Kirs67/undergrad-thesis/top_controller/top_controller.kicad_pcb

## KiCad design top_controller/top_controller.kicad_pcb (2023-03-27)

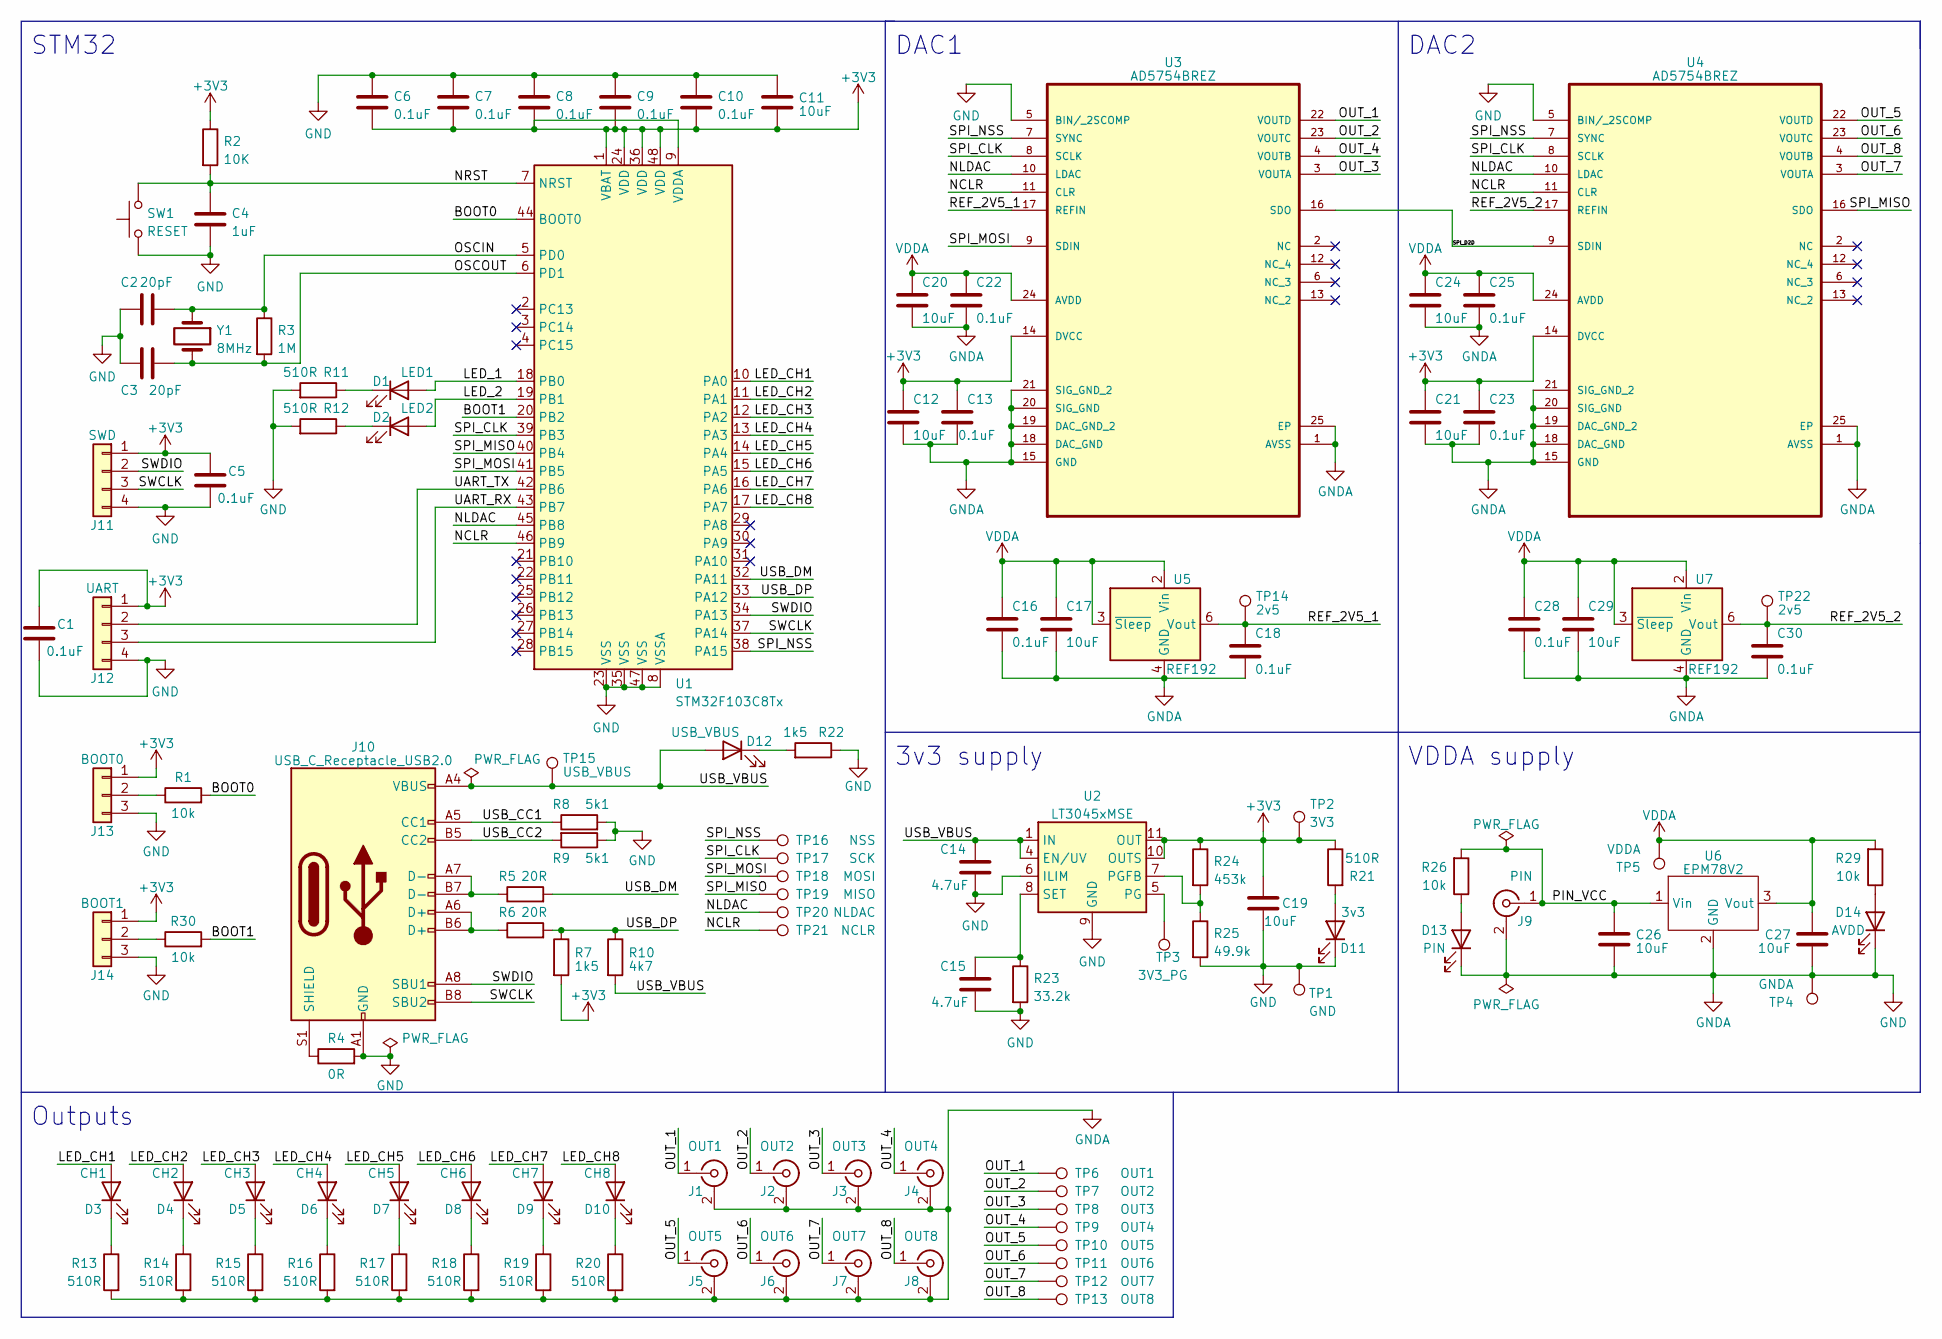
[picture p1: schematic top_controller.kicad_sch, Photonic control curcuit]

Parts:
C1, C5, C6, C7, C8, C9, C10, C13, C16, C18, C22, C23, C25, C28, C30: 0.1uF; C_0603_1608Metric
C2, C3: 20pF; C_0603_1608Metric
C4: 1uF; C_0603_1608Metric
C11, C12, C17, C19, C20, C21, C24, C26, C27, C29: 10uF; C_1206_3216Metric
C14, C15: 4.7uF; C_1206_3216Metric
D1: LED1; LED_0805_2012Metric
D2: LED2; LED_0805_2012Metric
D3: CH1; LED_0805_2012Metric
D4: CH2; LED_0805_2012Metric
D5: CH3; LED_0805_2012Metric
D6: CH4; LED_0805_2012Metric
D7: CH5; LED_0805_2012Metric
D8: CH6; LED_0805_2012Metric
D9: CH7; LED_0805_2012Metric
D10: CH8; LED_0805_2012Metric
D11: 3v3; LED_0805_2012Metric
D12: USB_VBUS; LED_0805_2012Metric
D13: PIN; LED_0805_2012Metric
D14: AVDD; LED_0805_2012Metric
J1: OUT1; CONBNC002
J2: OUT2; CONBNC002
J3: OUT3; CONBNC002
J4: OUT4; CONBNC002
J5: OUT5; CONBNC002
J6: OUT6; CONBNC002
J7: OUT7; CONBNC002
J8: OUT8; CONBNC002
J9: PIN; CONBNC002
J10: USB_C_Receptacle_USB2.0; USB_C_Receptacle_GCT_USB4105-xx-A_16P_TopMnt_Horizontal
J11: SWD; PinHeader_1x04_P2.54mm_Vertical
J12: UART; PinHeader_1x04_P2.54mm_Vertical
J13: BOOT0; PinHeader_1x03_P2.54mm_Vertical
J14: BOOT1; PinHeader_1x03_P2.54mm_Vertical
R1, R26, R29, R30: 10k; R_0603_1608Metric
R2: 10K; R_0603_1608Metric
R3: 1M; R_2512_6332Metric
R4: 0R; R_0603_1608Metric
R5, R6: 20R; R_0603_1608Metric
R7, R22: 1k5; R_0603_1608Metric
R8, R9: 5k1; R_0603_1608Metric
R10: 4k7; R_0603_1608Metric
R11, R12, R13, R14, R15, R16, R17, R18, R19, R20, R21: 510R; R_0603_1608Metric
R23: 33.2k; R_0603_1608Metric
R24: 453k; R_0805_2012Metric
R25: 49.9k; R_0603_1608Metric
SW1: RESET; SW_TS04-66-95-BK-100-SMT
TP1: GND; TestPoint_Keystone_5010-5014_Multipurpose
TP2: 3V3; TestPoint_Keystone_5010-5014_Multipurpose
TP3: 3V3_PG; TestPoint_Keystone_5010-5014_Multipurpose
TP4: GNDA; TestPoint_Keystone_5010-5014_Multipurpose
TP5: VDDA; TestPoint_Keystone_5010-5014_Multipurpose
TP6: OUT1; TestPoint_Keystone_5010-5014_Multipurpose
TP7: OUT2; TestPoint_Keystone_5010-5014_Multipurpose
TP8: OUT3; TestPoint_Keystone_5010-5014_Multipurpose
TP9: OUT4; TestPoint_Keystone_5010-5014_Multipurpose
TP10: OUT5; TestPoint_Keystone_5010-5014_Multipurpose
TP11: OUT6; TestPoint_Keystone_5010-5014_Multipurpose
TP12: OUT7; TestPoint_Keystone_5010-5014_Multipurpose
TP13: OUT8; TestPoint_Keystone_5010-5014_Multipurpose
TP14, TP22: 2v5; TestPoint_Keystone_5010-5014_Multipurpose
TP15: USB_VBUS; TestPoint_Keystone_5010-5014_Multipurpose
TP16: NSS; TestPoint_Keystone_5010-5014_Multipurpose
TP17: SCK; TestPoint_Keystone_5010-5014_Multipurpose
TP18: MOSI; TestPoint_Keystone_5010-5014_Multipurpose
TP19: MISO; TestPoint_Keystone_5010-5014_Multipurpose
TP20: NLDAC; TestPoint_Keystone_5010-5014_Multipurpose
TP21: NCLR; TestPoint_Keystone_5010-5014_Multipurpose
U1: STM32F103C8Tx; LQFP-48_7x7mm_P0.5mm
U2: LT3045xMSE; MSOP-12-1EP_3x4mm_P0.65mm_EP1.65x2.85mm
U3, U4: AD5754BREZ; SOP65P640X120-25N; MPN AD5754BREZ
U5, U7: REF192; SOIC-8_3.9x4.9mm_P1.27mm
U6: EPM78V2
Y1: 8MHz; Crystal_SMD_HC49-SD

Connections:
+3V3: C1.1, C5.1, C6.2, C7.2, C8.2, C9.2, C10.2, C11.2, C12.1, C13.1, C19.1, C21.1, C23.1, J11.1, J12.1, J13.1, J14.1, R2.1, R7.2, R21.1, R24.1, TP2.1, U1.1 (VBAT), U1.9 (VDDA), U1.24 (VDD), U1.36 (VDD), U1.48 (VDD), U2.10 (OUTS), U2.11 (OUT), U2.12 (OUT), U3.14 (DVCC), U4.14 (DVCC)
/BOOT0: R1.2, U1.44 (BOOT0)
/BOOT1: R30.2, U1.20 (PB2)
/LED_1: D1.2 (A), U1.18 (PB0)
/LED_2: D2.2 (A), U1.19 (PB1)
/LED_CH1: D3.2 (A), U1.10 (PA0)
/LED_CH2: D4.2 (A), U1.11 (PA1)
/LED_CH3: D5.2 (A), U1.12 (PA2)
/LED_CH4: D6.2 (A), U1.13 (PA3)
/LED_CH5: D7.2 (A), U1.14 (PA4)
/LED_CH6: D8.2 (A), U1.15 (PA5)
/LED_CH7: D9.2 (A), U1.16 (PA6)
/LED_CH8: D10.2 (A), U1.17 (PA7)
/NCLR: TP21.1, U1.46 (PB9), U3.11 (CLR), U4.11 (CLR)
/NLDAC: TP20.1, U1.45 (PB8), U3.10 (LDAC), U4.10 (LDAC)
/NRST: C4.1, R2.2, SW1.2, U1.7 (NRST)
/OSCIN: C2.1, R3.1, U1.5 (PD0), Y1.1
/OSCOUT: C3.1, R3.2, U1.6 (PD1), Y1.2
/OUT_1: J1.1 (In), TP6.1, U3.22 (VOUTD)
/OUT_2: J2.1 (In), TP7.1, U3.23 (VOUTC)
/OUT_3: J3.1 (In), TP8.1, U3.3 (VOUTA)
/OUT_4: J4.1 (In), TP9.1, U3.4 (VOUTB)
/OUT_5: J5.1 (In), TP10.1, U4.22 (VOUTD)
/OUT_6: J6.1 (In), TP11.1, U4.23 (VOUTC)
/OUT_7: J7.1 (In), TP12.1, U4.3 (VOUTA)
/OUT_8: J8.1 (In), TP13.1, U4.4 (VOUTB)
/PIN_VCC: C26.1, J9.1 (In), R26.2, U6.1 (Vin)
/REF_2V5_1: C18.1, TP14.1, U3.17 (REFIN), U5.6 (Vout)
/REF_2V5_2: C30.1, TP22.1, U4.17 (REFIN), U7.6 (Vout)
/SPI_CLK: TP17.1, U1.39 (PB3), U3.8 (SCLK), U4.8 (SCLK)
/SPI_D2D: U3.16 (SDO), U4.9 (SDIN)
/SPI_MISO: TP19.1, U1.40 (PB4), U4.16 (SDO)
/SPI_MOSI: TP18.1, U1.41 (PB5), U3.9 (SDIN)
/SPI_NSS: TP16.1, U1.38 (PA15), U3.7 (SYNC), U4.7 (SYNC)
/SWCLK: J10.B8 (SBU2), J11.3, U1.37 (PA14)
/SWDIO: J10.A8 (SBU1), J11.2, U1.34 (PA13)
/UART_RX: J12.3, U1.43 (PB7)
/UART_TX: J12.2, U1.42 (PB6)
/USB_CC1: J10.A5 (CC1), R8.1
/USB_CC2: J10.B5 (CC2), R9.2
/USB_DM: R5.2, U1.32 (PA11)
/USB_DP: R6.2, R7.1, R10.1, U1.33 (PA12)
/USB_VBUS: C14.1, D12.2 (A), J10.A4 (VBUS), J10.A9 (VBUS), J10.B4 (VBUS), J10.B9 (VBUS), R10.2, TP15.1, U2.1 (IN), U2.2 (IN), U2.3 (IN), U2.4 (EN/UV)
GND: C1.2, C2.2, C3.2, C4.2, C5.2, C6.1, C7.1, C8.1, C9.1, C10.1, C11.1, C12.2, C13.2, C14.2, C15.2, C16.2, C17.2, C18.2, C19.2, C20.2, C21.2, C22.2, C23.2, C24.2, C25.2, C26.2, C27.2, C28.2, C29.2, C30.2, D11.1 (K), D13.1 (K), D14.1 (K), J1.2 (Ext), J2.2 (Ext), J3.2 (Ext), J4.2 (Ext), J5.2 (Ext), J6.2 (Ext), J7.2 (Ext), J8.2 (Ext), J9.2 (Ext), J10.A1 (GND), J10.A12 (GND), J10.B1 (GND), J10.B12 (GND), J11.4, J12.4, J13.3, J14.3, R4.2, R8.2, R9.1, R11.2, R12.2, R13.2, R14.2, R15.2, R16.2, R17.2, R18.2, R19.2, R20.2, R22.1, R23.2, R25.2, SW1.1, TP1.1, TP4.1, U1.8 (VSSA), U1.23 (VSS), U1.35 (VSS), U1.47 (VSS), U2.6 (ILIM), U2.9 (GND), U2.13 (GND), U3.1 (AVSS), U3.5 (BIN/_2SCOMP), U3.15 (GND), U3.18 (DAC_GND), U3.19 (DAC_GND_2), U3.20 (SIG_GND), U3.21 (SIG_GND_2), U3.25 (EP), U4.1 (AVSS), U4.5 (BIN/_2SCOMP), U4.15 (GND), U4.18 (DAC_GND), U4.19 (DAC_GND_2), U4.20 (SIG_GND), U4.21 (SIG_GND_2), U4.25 (EP), U5.4 (GND), U6.2 (GND), U7.4 (GND)
unnamed: D1.1 (K), R11.1
unnamed: D2.1 (K), R12.1
unnamed: D3.1 (K), R13.1
unnamed: D4.1 (K), R14.1
unnamed: D5.1 (K), R15.1
unnamed: D6.1 (K), R16.1
unnamed: D7.1 (K), R17.1
unnamed: D8.1 (K), R18.1
unnamed: D9.1 (K), R19.1
unnamed: D10.1 (K), R20.1
unnamed: D11.2 (A), R21.2
unnamed: D12.1 (K), R22.2
unnamed: D13.2 (A), R26.1
unnamed: D14.2 (A), R29.1
unnamed: J10.A6 (D+), J10.B6 (D+), R6.1
unnamed: J10.A7 (D-), J10.B7 (D-), R5.1
unnamed: J10.S1 (SHIELD), R4.1
unnamed: J13.2, R1.1
unnamed: J14.2, R30.1
unnamed: TP3.1, U2.5 (PG)
unnamed: R24.2, R25.1, U2.7 (PGFB)
unnamed: C15.1, R23.1, U2.8 (SET)
VDDA: C16.1, C17.1, C20.1, C22.1, C24.1, C25.1, C27.1, C28.1, C29.1, R29.2, TP5.1, U3.24 (AVDD), U4.24 (AVDD), U5.2 (Vin), U5.3 (~Sleep), U6.3 (Vout), U7.2 (Vin), U7.3 (~Sleep)

Notes on the sheet:
DAC2
3v3 supply
Outputs
DAC1
VDDA supply
STM32

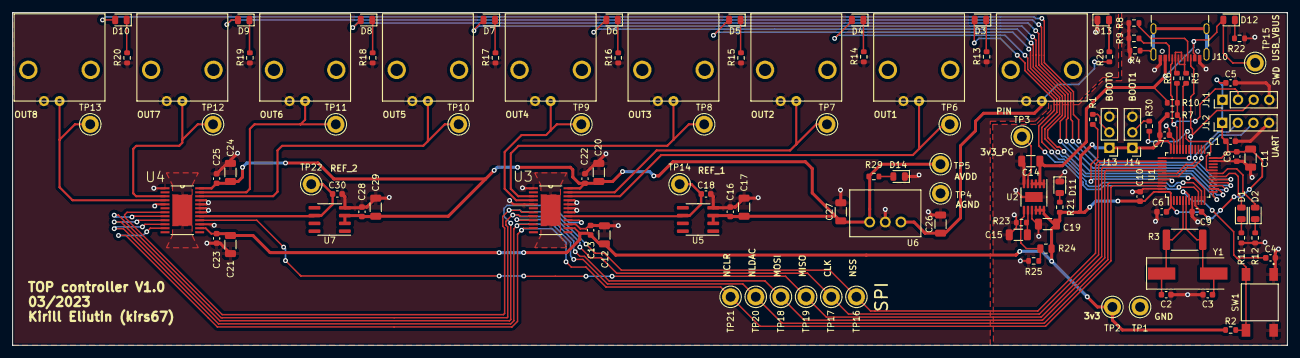
[picture p2: board top_controller.kicad_pcb from above]

Board: 2 copper layers, 207.7 x 54.2 mm, 117 parts (0 on the bottom side), 67 nets.
