Kirs67/undergrad-thesis/stm32_proj/stm32_proj.ioc

Mcu.UserName=STM32F103C8Tx
PA0-WKUP.GPIO_Label=LED_CH1
PA0-WKUP.Signal=GPIO_Output
PA1.GPIO_Label=LED_CH2
PA1.Signal=GPIO_Output
PA11.Signal=USB_DM
PA12.Signal=USB_DP
PA13.Signal=SYS_JTMS-SWDIO
PA14.Signal=SYS_JTCK-SWCLK
PA15.Signal=SPI1_NSS
PA2.GPIO_Label=LED_CH3
PA2.Signal=GPIO_Output
PA3.GPIO_Label=LED_CH4
PA3.Signal=GPIO_Output
PA4.GPIO_Label=LED_CH5
PA4.Signal=GPIO_Output
PA5.GPIO_Label=LED_CH6
PA5.Signal=GPIO_Output
PA6.GPIO_Label=LED_CH7
PA6.Signal=GPIO_Output
PA7.GPIO_Label=LED_CH8
PA7.Signal=GPIO_Output
PB0.GPIO_Label=LED1
PB0.Signal=GPIO_Output
PB1.GPIO_Label=LED2
PB1.Signal=GPIO_Output
PB2.GPIO_Label=BOOT1
PB2.Signal=GPIO_Input
PB3.Signal=SPI1_SCK
PB4.Signal=SPI1_MISO
PB5.Signal=SPI1_MOSI
PB6.Signal=USART1_TX
PB7.Signal=USART1_RX
PB8.GPIO_Label=NLDAC
PB8.Signal=GPIO_Output
PB9.GPIO_Label=NCLR
PB9.Signal=GPIO_Output
PD0-OSC_IN.Signal=RCC_OSC_IN
PD1-OSC_OUT.Signal=RCC_OSC_OUT
