Kirs67/undergrad-thesis/(commit log)

2023-03-12 Most of the schematic done
    [top_controller.kicad_pcb, top_controller.kicad_sch]
2023-03-20 schematic is finished (except LEDs)
    [top_controller.kicad_sch]
2023-03-20 Finalized the schematic Added LEDs and UART
    [top_controller.kicad_sch]
2023-03-21 Small fixes - Power supplied to VBAT of STM32 - Added 10uF cap for the whole STM32 - Added BOOT0 switch - Labelled some unlabelled nets - Added resistor between USB connector SHIELD and GND - Marked 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
    [top_controller.kicad_sch]
2023-03-21 Assigned footprints
    [top_controller.kicad_sch]
2023-03-21 Added testpoints
    [top_controller.kicad_sch]
2023-03-22 Added BOOT1
    [top_controller.kicad_sch]
2023-03-24 Part of the board is done
    [top_controller.kicad_pcb, top_controller.kicad_sch]
2023-03-26 Added second voltage reference
    [top_controller.kicad_pcb, top_controller.kicad_sch]
2023-03-26 GNDA and VDDA redone properly, slightly changed component placement in the schematic
    [top_controller.kicad_sch]
2023-03-26 Restructured schematic again - LEDs moved to better locations
    [top_controller.kicad_sch]
2023-03-26 Added capacitors around DC-DC regulator
    [top_controller.kicad_pcb, top_controller.kicad_sch]
2023-03-26 Changed STM LED pins to more convenient ones
    [top_controller.kicad_pcb, top_controller.kicad_sch]
2023-03-26 Changed data pins on STM32 for easier tracing
    [top_controller.kicad_pcb, top_controller.kicad_sch]
2023-03-26 Placed all the components
    [top_controller.kicad_pcb]
2023-03-26 Reordered output channels on DACs for easier tracing
    [top_controller.kicad_sch]
2023-03-27 Most of the signals routed
    [top_controller.kicad_pcb]
2023-03-27 Finished all the traces (except connecting two grounds and testpoints on SPI)
    [top_controller.kicad_pcb]
2023-03-27 Finished tracing - still some errors present
    [top_controller.kicad_pcb, top_controller.kicad_sch]
2023-03-27 Fixed a bunch of DRC errors - Fixed couple place where 3v3 was not routed - Allowed for 1 connection between pad and thermal relief (cause kicad counts just connectin a pad to the ground plane as the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
    [top_controller.kicad_pcb]
2023-03-27 Increased silkscreen thickness from 0.15 to 0.153
    [top_controller.kicad_pcb]
2023-03-27 Fixed most of the silk issues (except BNC connectors having outline too close to the edge)
    [top_controller.kicad_pcb]
2023-03-27 Cut Type C connector pands to meet the constraints
    [top_controller.kicad_pcb]
2023-03-27 DRC errors solved
    [top_controller.kicad_pcb]
2023-03-27 Made power traces wider
    [top_controller.kicad_pcb]
2023-03-27 Increased output traces width
    [top_controller.kicad_pcb]
2023-03-27 Added labels on silkscreen
    [top_controller.kicad_pcb]
2023-03-27 Generated Gerber and drill files
    [top_controller-B_Cu.gbr, top_controller-B_Mask.gbr, top_controller-B_Paste.gbr, top_controller-B_Silkscreen.gbr, top_controller-Edge_Cuts.gbr, top_controller-F_Cu.gbr, top_controller-F_Mask.gbr, top_controller-F_Paste.gbr]
2023-03-28 Added a place for JLCPCB order number
    [top_controller-F_Silkscreen.gbr]
